DaveLangstaff/Enfys-Arduino/EGSE Board/EGSE.kicad_sch

## KiCad design EGSE Board/EGSE.kicad_sch (2024-02-21)

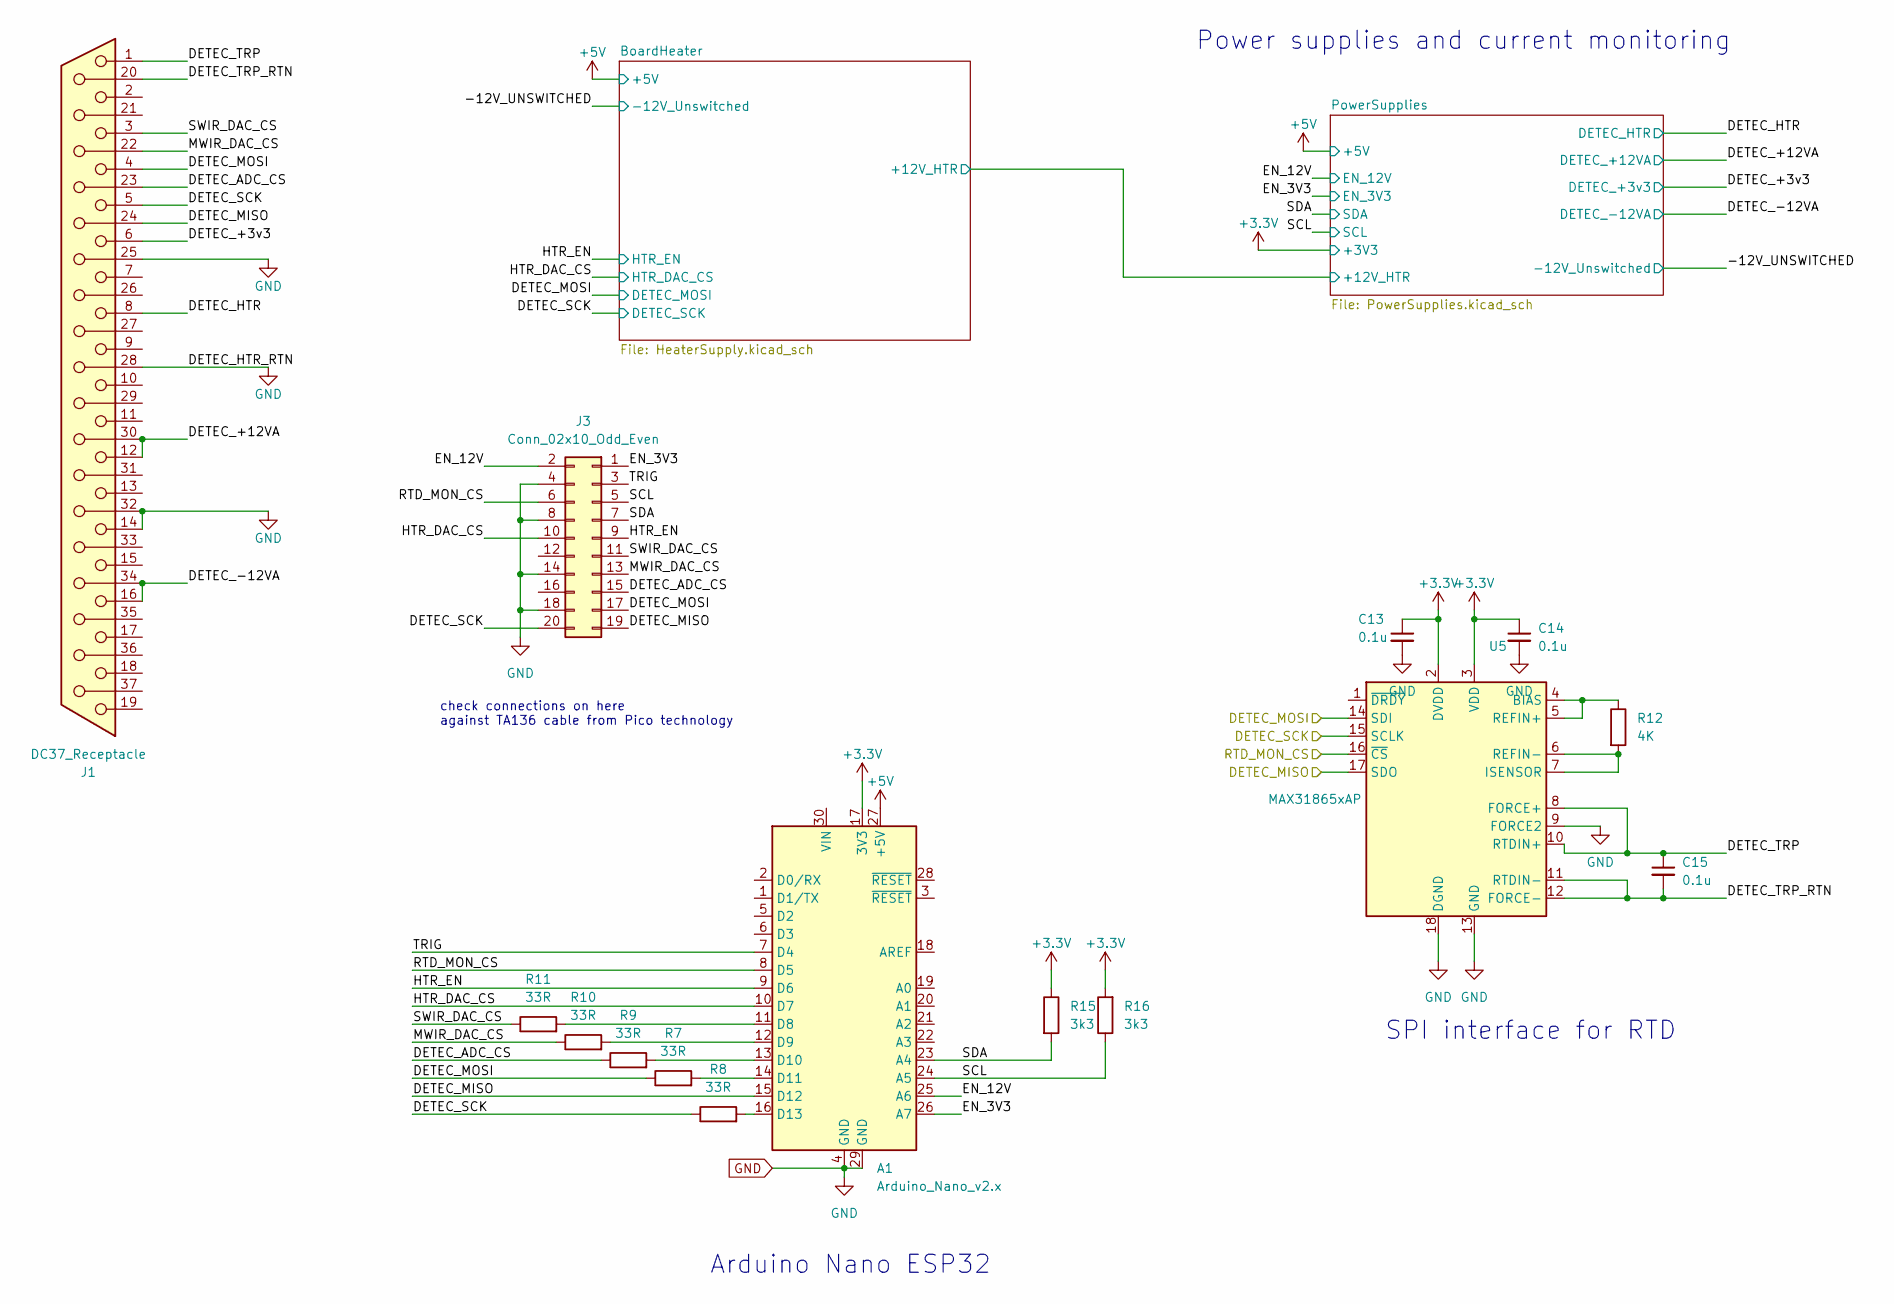
[picture p1: schematic EGSE.kicad_sch]

Parts:
A1: Arduino_Nano_v2.x; Arduino_Nano
C13, C14, C15: 0.1u; C_0402_1005Metric
J1: DC37_Receptacle; DSUB-37_Female_Vertical_P2.77x2.84mm_MountingHoles
J3: Conn_02x10_Odd_Even; PinHeader_2x10_P2.54mm_Vertical
R7, R8, R9, R10, R11: 33R; R_0805_2012Metric
R12: 4K; R_0805_2012Metric
R15, R16: 3k3; R_0805_2012Metric
U5: MAX31865xAP; SSOP-20_5.3x7.2mm_P0.65mm

Connections:
+3.3V: A1.17 (3V3), C13.1, C14.1, R15.1, R16.2, U5.2 (DVDD), U5.3 (VDD)
+5V: A1.27 (+5V)
DETEC_+3v3: J1.6
DETEC_+12VA: J1.12, J1.30
DETEC_-12VA: J1.16, J1.34
DETEC_ADC_CS: J1.23, J3.15, R9.1
DETEC_HTR: J1.8
DETEC_MISO: A1.15 (D12), J1.24, J3.19, U5.17 (SDO)
DETEC_MOSI: J1.4, J3.17, R7.1, U5.14 (SDI)
DETEC_SCK: J1.5, J3.20, R8.1, U5.15 (SCLK)
DETEC_TRP: C15.1, J1.1, U5.8 (FORCE+), U5.10 (RTDIN+)
DETEC_TRP_RTN: C15.2, J1.20, U5.11 (RTDIN-), U5.12 (FORCE-)
EN_3V3: A1.26 (A7), J3.1
EN_12V: A1.25 (A6), J3.2
GND: A1.4 (GND), A1.29 (GND), C13.2, C14.2, J1.14, J1.25, J1.28, J1.32, J3.4, J3.8, J3.14, J3.18, U5.9 (FORCE2), U5.13 (GND), U5.18 (DGND), U5.19 (GND)
HTR_DAC_CS: A1.10 (D7), J3.10
HTR_EN: A1.9 (D6), J3.9
MWIR_DAC_CS: J1.22, J3.13, R10.1
unnamed: A1.11 (D8), R11.2
unnamed: A1.12 (D9), R10.2
unnamed: A1.13 (D10), R9.2
unnamed: A1.14 (D11), R7.2
unnamed: A1.16 (D13), R8.2
unnamed: R12.1, U5.4 (BIAS), U5.5 (REFIN+)
unnamed: R12.2, U5.6 (REFIN-), U5.7 (ISENSOR)
RTD_MON_CS: A1.8 (D5), J3.6, U5.16 (~CS)
SCL: A1.24 (A5), J3.5, R16.1
SDA: A1.23 (A4), J3.7, R15.2
SWIR_DAC_CS: J1.3, J3.11, R11.1
TRIG: A1.7 (D4), J3.3

Notes on the sheet:
Arduino Nano ESP32
check connections on here against TA136 cable from Pico technology
SPI interface for RTD
Power supplies and current monitoring
