DaveLangstaff/Enfys-Arduino/EGSE Board/HeaterSupply.kicad_sch

## KiCad design EGSE Board/HeaterSupply.kicad_sch (2024-03-08)

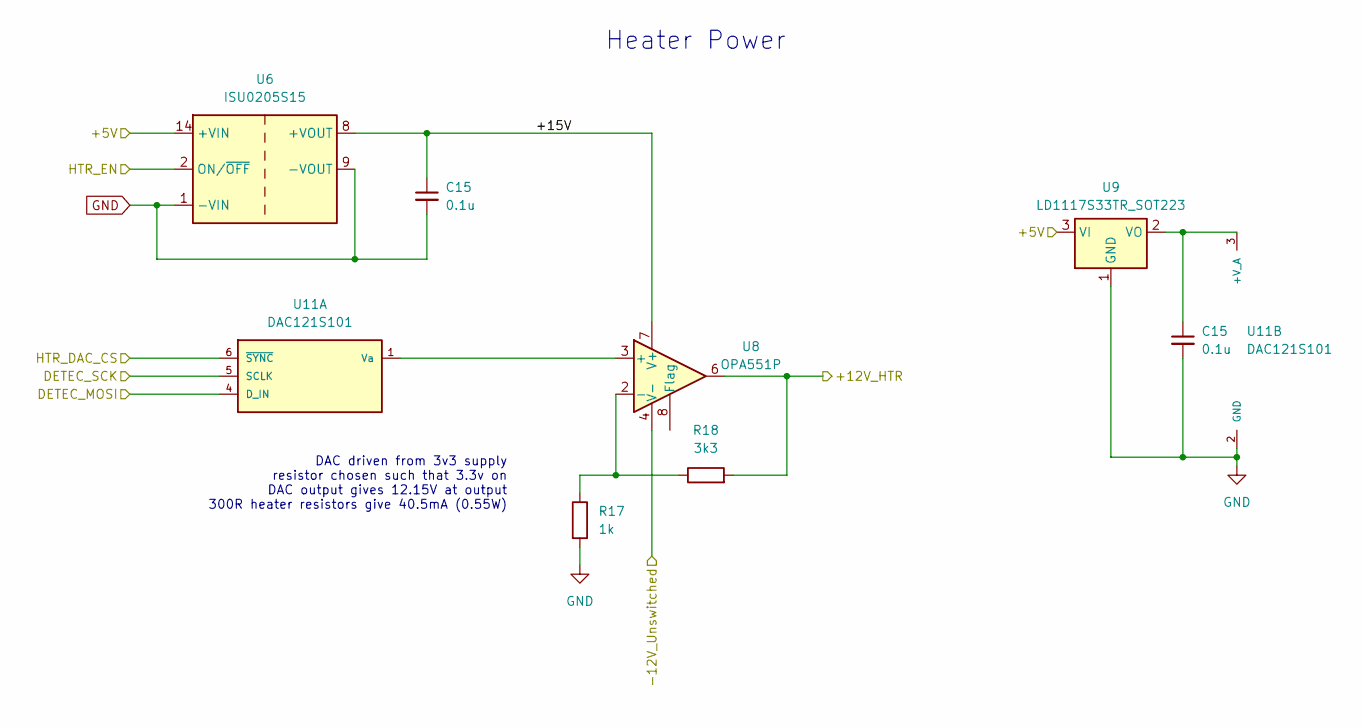
[picture p2: schematic HeaterSupply.kicad_sch]

Parts:
C15: 0.1u; C_0402_1005Metric
R17: 1k; R_0805_2012Metric
R18: 3k3; R_0805_2012Metric
U6: ISU0205S15; Converter_DCDC_XP_POWER-ISU02_SMD
U8: OPA551P; DIP-8_W7.62mm
U9: LD1117S33TR_SOT223; SOT-223-3_TabPin2
U11: DAC121S101; SOT-23-6

Connections:
+5V: U6.14 (+VIN), U9.3 (VI)
+12V_HTR: R18.2, U8.6
+15V: C15.1, U6.8 (+VOUT), U8.7 (V+)
-12V_Unswitched: U8.4 (V-)
DETEC_MOSI: U11.4 (D_IN)
DETEC_SCK: U11.5 (SCLK)
GND: C15.2, R17.2, U6.1 (-VIN), U6.9 (-VOUT), U9.1 (GND), U11.2 (GND)
HTR_DAC_CS: U11.6 (~SYNC)
HTR_EN: U6.2 (ON/~OFF)
unnamed: C15.1, U9.2 (VO), U11.3 (+V_A)
unnamed: R17.1, R18.1, U8.2 (-)
unnamed: U8.3 (+), U11.1 (Va)

Notes on the sheet:
Heater Power
DAC driven from 3v3 supply resistor chosen such that 3.3v on DAC output gives 12.15V at output 300R heater resistors give 40.5mA (0.55W)
