DaveLangstaff/Enfys-Arduino/EGSE Board/PowerSupplies.kicad_sch

## KiCad design EGSE Board/PowerSupplies.kicad_sch (2024-02-21)

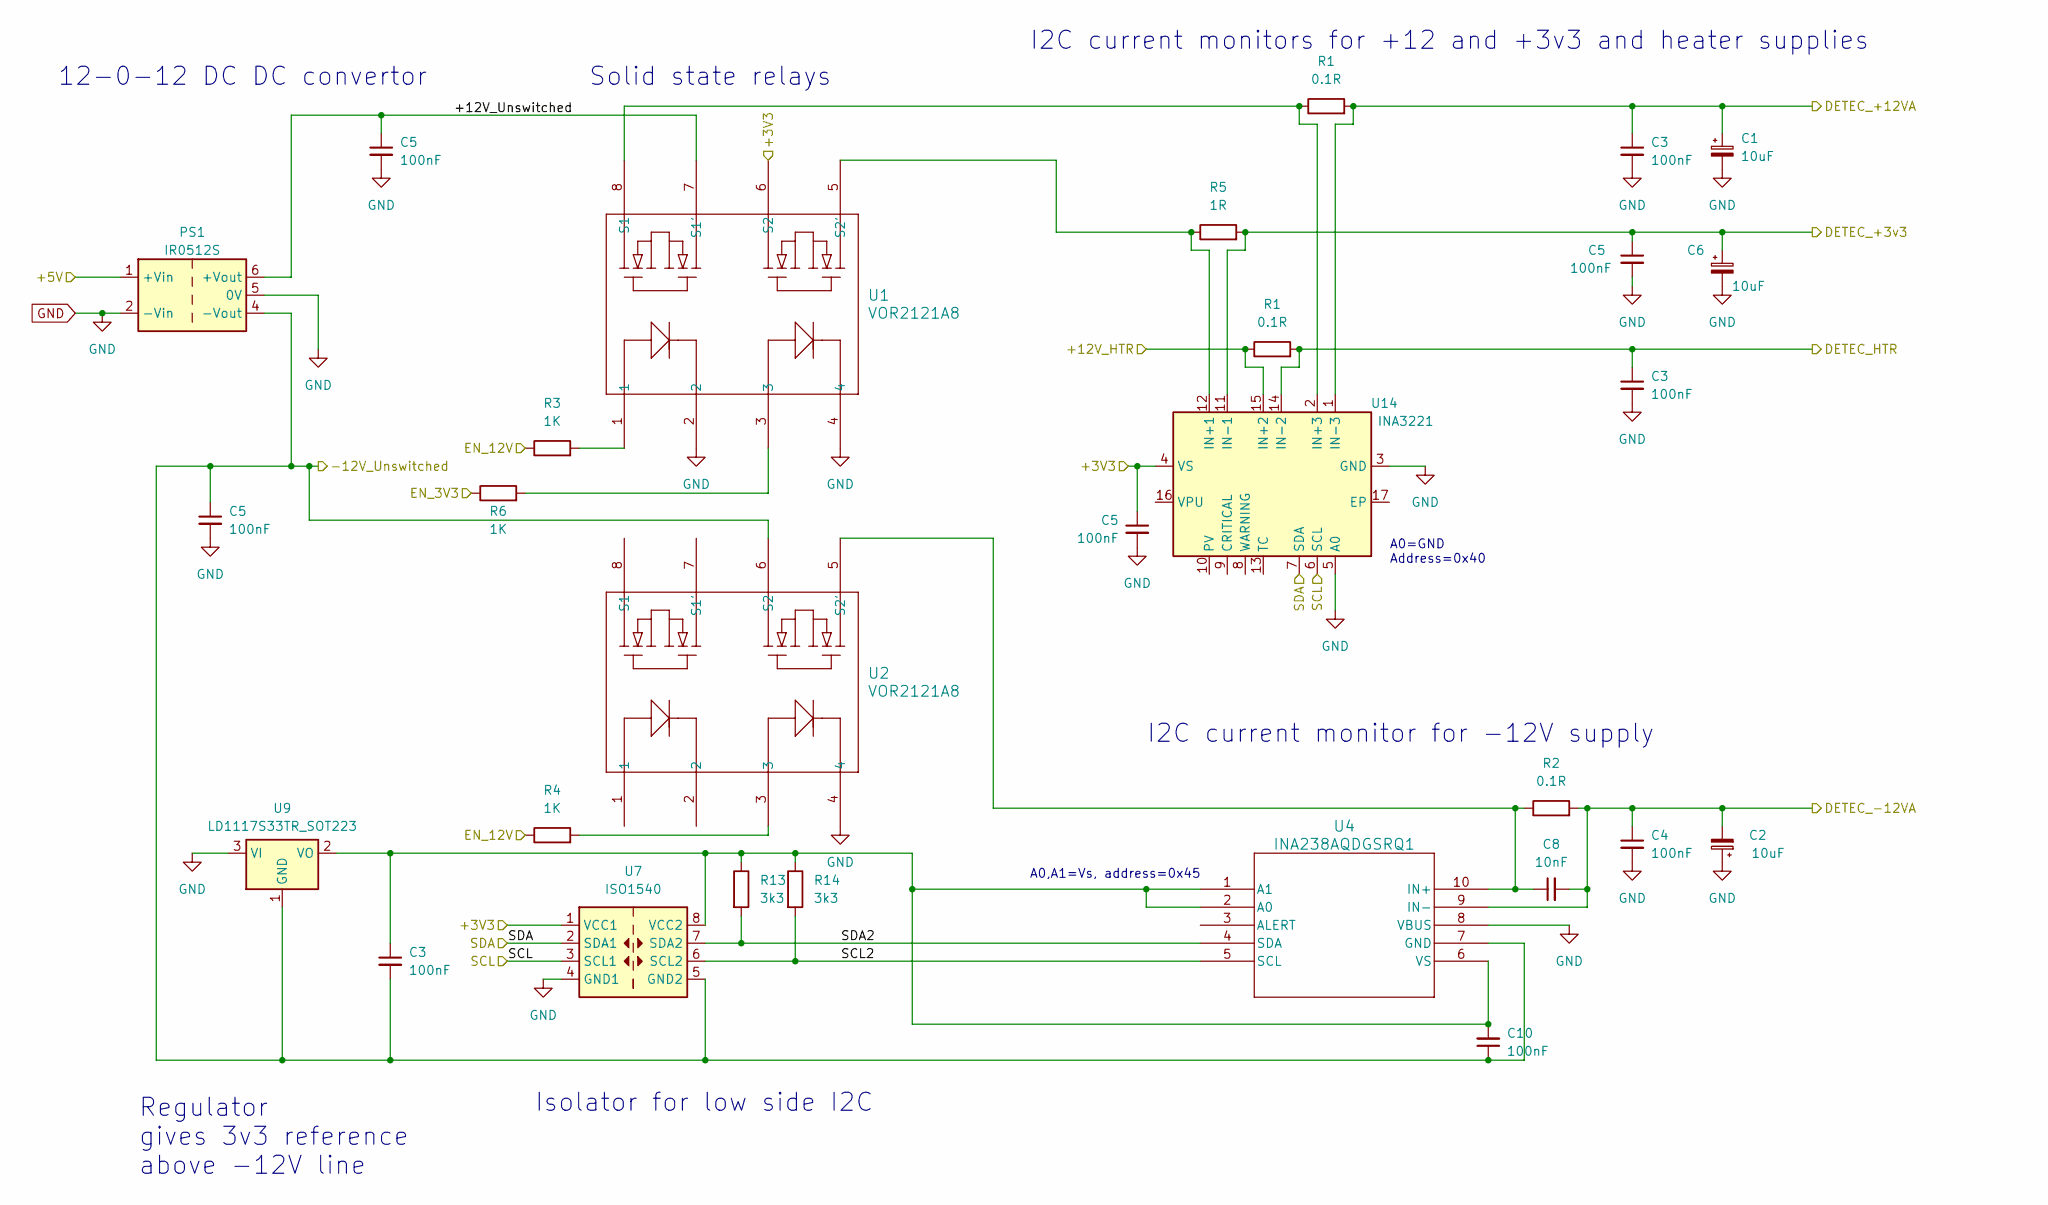
[picture p3: schematic PowerSupplies.kicad_sch]

Parts:
C1, C2, C6: 10uF; CP_EIA-7343-31_Kemet-D_Pad2.25x2.55mm_HandSolder
C3, C4, C5, C10: 100nF; C_0402_1005Metric
C8: 10nF; C_0402_1005Metric
PS1: IR0512S; Converter_DCDC_XP_POWER-IAxxxxD_THT
R1, R2: 0.1R; R_Axial_DIN0207_L6.3mm_D2.5mm_P7.62mm_Horizontal
R3, R4, R6: 1K; R_0805_2012Metric
R5: 1R; R_Axial_DIN0207_L6.3mm_D2.5mm_P7.62mm_Horizontal
R13, R14: 3k3; R_0805_2012Metric
U1, U2: VOR2121A8; DIP-8_W7.62mm
U4: INA238AQDGSRQ1; VSSOP-10_3x3mm_P0.5mm
U7: ISO1540; SOIC-8_3.9x4.9mm_P1.27mm
U9: LD1117S33TR_SOT223; SOT-223-3_TabPin2
U14: INA3221; Texas_RGV_S-PVQFN-N16_EP2.1x2.1mm

Connections:
+3V3: C5.1, U1.6 (S2), U7.1 (VCC1), U14.4 (VS)
+5V: PS1.1 (+Vin)
+12V_HTR: R1.1, U14.15 (IN+2)
+12V_Unswitched: C5.1, PS1.6 (+Vout), U1.7 (S1')
-12V_Unswitched: C3.2, C5.1, C10.1, PS1.4 (-Vout), U2.6 (S2), U4.7 (GND), U7.5 (GND2), U9.1 (GND)
DETEC_+3v3: C5.1, C6.1, R5.2, U14.11 (IN-1)
DETEC_+12VA: C1.1, C3.1, R1.2, U14.1 (IN-3)
DETEC_-12VA: C2.2, C4.1, C8.2, R2.2, U4.9 (IN-)
DETEC_HTR: C3.1, R1.2, U14.14 (IN-2)
EN_3V3: R6.1
EN_12V: R3.1, R4.1
GND: C1.2, C2.1, C3.2, C4.2, C5.2, C6.2, PS1.2 (-Vin), PS1.5 (0V), U1.2, U1.4, U2.4, U4.8 (VBUS), U7.4 (GND1), U9.3 (VI), U14.3 (GND), U14.5 (A0)
unnamed: C8.1, R2.1, U2.5 (S2'), U4.10 (IN+)
unnamed: C3.1, C10.2, R13.1, R14.1, U4.1 (A1), U4.2 (A0), U4.6 (VS), U7.8 (VCC2), U9.2 (VO)
unnamed: R1.1, U1.8 (S1), U14.2 (IN+3)
unnamed: R3.2, U1.1
unnamed: R4.2, U2.3
unnamed: R5.1, U1.5 (S2'), U14.12 (IN+1)
unnamed: R6.2, U1.3
SCL: U7.3 (SCL1), U14.6 (SCL)
SCL2: R14.2, U4.5 (SCL), U7.6 (SCL2)
SDA: U7.2 (SDA1), U14.7 (SDA)
SDA2: R13.2, U4.4 (SDA), U7.7 (SDA2)

Notes on the sheet:
I2C current monitors for +12 and +3v3 and heater supplies
A0=GND Address=0x40
Solid state relays
A0,A1=Vs, address=0x45
Isolator for low side I2C
12-0-12 DC DC convertor
I2C current monitor for -12V supply
Regulator gives 3v3 reference above -12V line
