DaveLangstaff/Enfys-Arduino/(commit log)

2024-01-30 Made OS sample size
    Changed OS and OS? to work with OSvalue rather than OSLevel
    Allows choice of any nuber of samples in range 1..1024
2024-01-30 Add dummy read
    Added a dummy read at start of ReadADCtoBuffer to allow for the fact that first reading on new channel is wrong.
    [DetectorBoard_SCPI_v2.ino]
2024-02-01 OS upgrade
    Defined Oversampling using MaxDataSize definition so facilitte changing it.
    Added THROW and THROW? to set throwAway defining how many samples to throw away before starting to fill the buffer
2024-02-01 With error codes
    All commands now return error codes
    ERR_NO_ERROR 0
    ERR_BAD_COMMAND -1
    ERR_TIMEOUT -2
    ERR_BUFF_OVERFLOW -3
    ERR_BAD_SUFFIX -4
    ERR_BAD_PARAM -5
    Setting commands will return the error code, query commands will either return data or an error code if a bad suffix is called for
    [DetectorBoard_SCPI_v2.ino]
2024-02-07 Fixed off-by-one errors with THROW and OS
    [DetectorBoard_SCPI_v2.ino]
2024-02-07 Fixed off-by-one in BURST mode command
    [DetectorBoard_SCPI_v2.ino]
2024-02-10 Added EGSE Board
    [EGSE Board.kicad_pcb, EGSE Board.kicad_sch]
2024-02-10 Added EGSE Board
    Added Kicad files for EGCE board based on Arduino Nano
    [EGSE Board.kicad_pcb, EGSE Board.kicad_sch]
2024-02-11 Major update
    Changed name to EGSE
    Udated design to include current pmonitors
    Imported symbols and footprints for SSR, DCDC convertor & IN238 current monitors
    [EGSE Board.kicad_sch, EGSE.kicad_pcb, EGSE.kicad_sch]
2024-02-12 Split Sheets
    Added sheet to cover Power supplies and monitoring
    Modified design to have monitor for -12VA supply running of -12V line with isolated I2C but
    [EGSE.kicad_sch, PowerSupplies.kicad_sch]
2024-02-14 EGSE board updates
    [EGSE.kicad_sch, HeaterSupply.kicad_sch]
2024-02-14 Change to heater power
    [EGSE.kicad_sch, HeaterSupply.kicad_sch, PowerSupplies.kicad_sch]
2024-02-16 Friday updates. PCB first draft
    [EGSE.kicad_pcb, EGSE.kicad_sch, HeaterSupply.kicad_sch, PowerSupplies.kicad_sch]
2024-02-21 Regular update
    Created Gerber files for production
    Changed names in arduino code to reflect signal names used by MSSL and on EGSE board
    [EGSE-B_Cu.gbr, EGSE-B_Mask.gbr, EGSE-B_Paste.gbr, EGSE-B_Silkscreen.gbr, EGSE-Edge_Cuts.gbr, EGSE-F_Cu.gbr, EGSE-F_Mask.gbr, EGSE-F_Paste.gbr]
2024-02-21 Update Arduino code
    Updated Arduino code to reflect names used on EGSE board
    Added libraries for INA devices (current monitors) and MAX31865 (RTD reading)
2024-02-26 PCB Second draft
    Final PCB and Gerber files for production
    [EGSE-B_Cu.gbr, EGSE-B_Mask.gbr, EGSE-B_Paste.gbr, EGSE-B_Silkscreen.gbr, EGSE-Edge_Cuts.gbr, EGSE-F_Cu.gbr, EGSE-F_Mask.gbr, EGSE-F_Paste.gbr]
2024-03-08 SCPI Parser fix
    Changed SCPI_HASH_TYPE to avoid hash conflicts
    Moved SCPI defines to above the line including vrekrer_scpi_parser.h
    Added commands to interface with INA3xxx current monitor and MAX31865 RTD controller
    Added *DBG command to print debug information from parser
    [DetectorBoard_SCPI_v2.ino]
2024-06-25 Update DetectorBoard_SCPI_v2.ino
    Added CLK and CLK? to set and query SPI clock
2024-10-09 Major update
    Moved ID & version string to top of file for ease of use.
    Increased MAX_TOKENS in SCPI parser
    Defined TRIG2 to work with BNC connector added to EGSE board
    Defined 0R15 ohm shunt resistor for INA devices
    Increased oversample and throwaway maximums to 4096
    Added ClkSpeed variable along with SetClkSpeed() and GetCLkspeed functions as well as CLK and CLK? commands for SCPI parser.
    Used ClkSpeed rather than Clockspeed throughout
    Moved Serial.begin() to start of setup() to allow debug info to be printed during boot
    Changed HTR_EN to be active LOW
    Changed setup of INA devices to allow debug printing and also to set conversion times etc.
    Amended PrintDebugInfo command to print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
2024-10-09 Major update
    Amended PrintDebugInfo command to print debug inf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
    [EGSE.kicad_pcb]
2024-11-15 SCIENCE Added
    Added SCIENCE? command to command set.
    This will read all 8 ADC channels according to current THROW and OS parameters. Each channel is summed and the result bit shifted to drop the 4 LSBs before returning data from all 8 channels as a comma seperated string.
2025-08-04 Changed version number to 2.3 Removed routines and commands referring to HTR_DAC Ensured all SPI bus lines are held low before 3v3 and 12v power applied to board SPI_CS bus lines set high after 3v3 a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
2025-08-04 Enabled DOUT#? to read back value set on SWIR and MWIR DACs Arranged SWIR and MWIR DACs to be set to 100 at initial power on
2025-08-05 V2.5 Changed to using MODE3 for reading out ADC
    V2.6
    Set default and minimum value of throwAway to 1 (ADC datasheet - first read is of random channel
    Updated setThrowAway to use minimum value of 1 for Throwaway
    Removed extra toggling of DETEC_ADC_CS to read all of one ADC channel continuously
2025-09-03 Added facility to disable access to any functions that interact with the SPI bus while the power is not applied. This is to ensure that all SPI lines are low when power is not applied to the detector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
2025-11-21 Update README with current and voltage monitoring info
    Added details for current and voltage monitoring commands.
2025-11-21 Update README with power and temperature commands
    Added commands for power control and temperature retrieval.
